technoblogy/alphanumeric-display/README.md

# Eight-Character Alphanumeric Display
An eight-character alphanumeric LED display with an I2C interface, based on four two-character 14-segment alphanumeric display modules and a low-cost HT16K33 display-driver chip.

For more information see: <http://www.technoblogy.com/show?2ULE>.
