technoblogy/alphanumeric-display/AlphanumericDisplaySchematic.gif

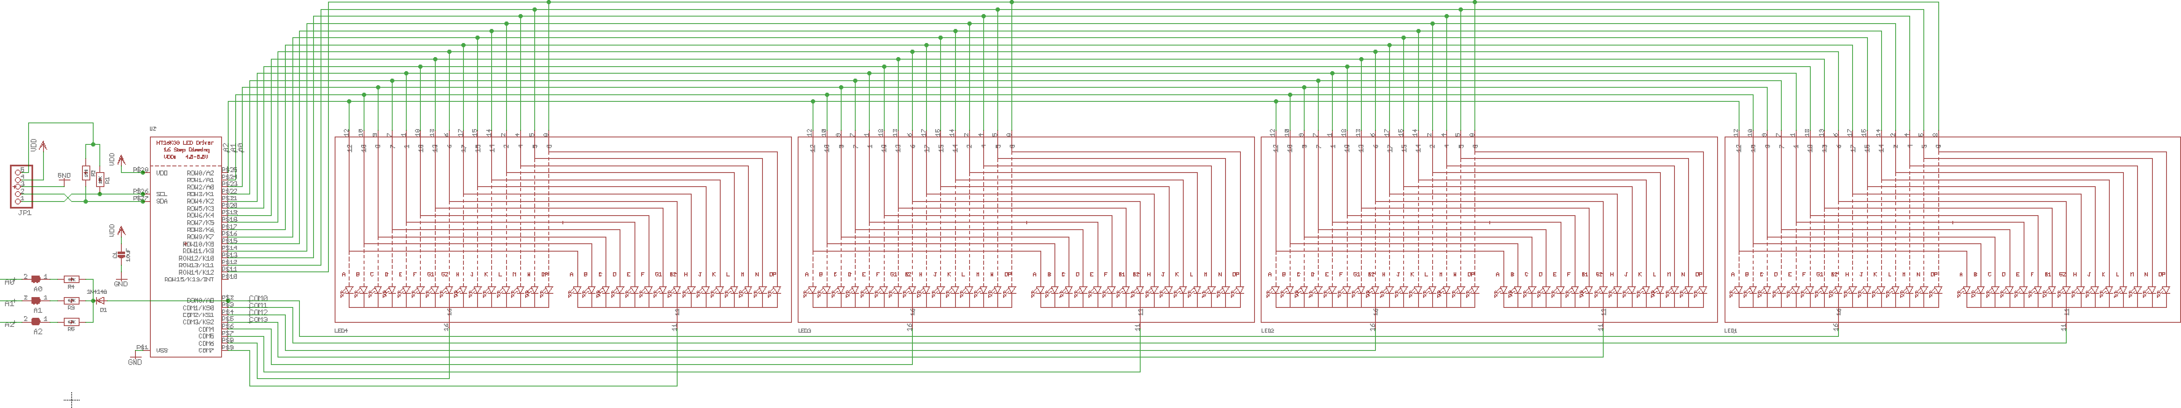
AlphanumericDisplaySchematic.gif
