technoblogy/alphanumeric-display/Eagle files/AlphanumericDisplay.brd

## EAGLE design Eagle files/AlphanumericDisplay.brd (2019-12-16)

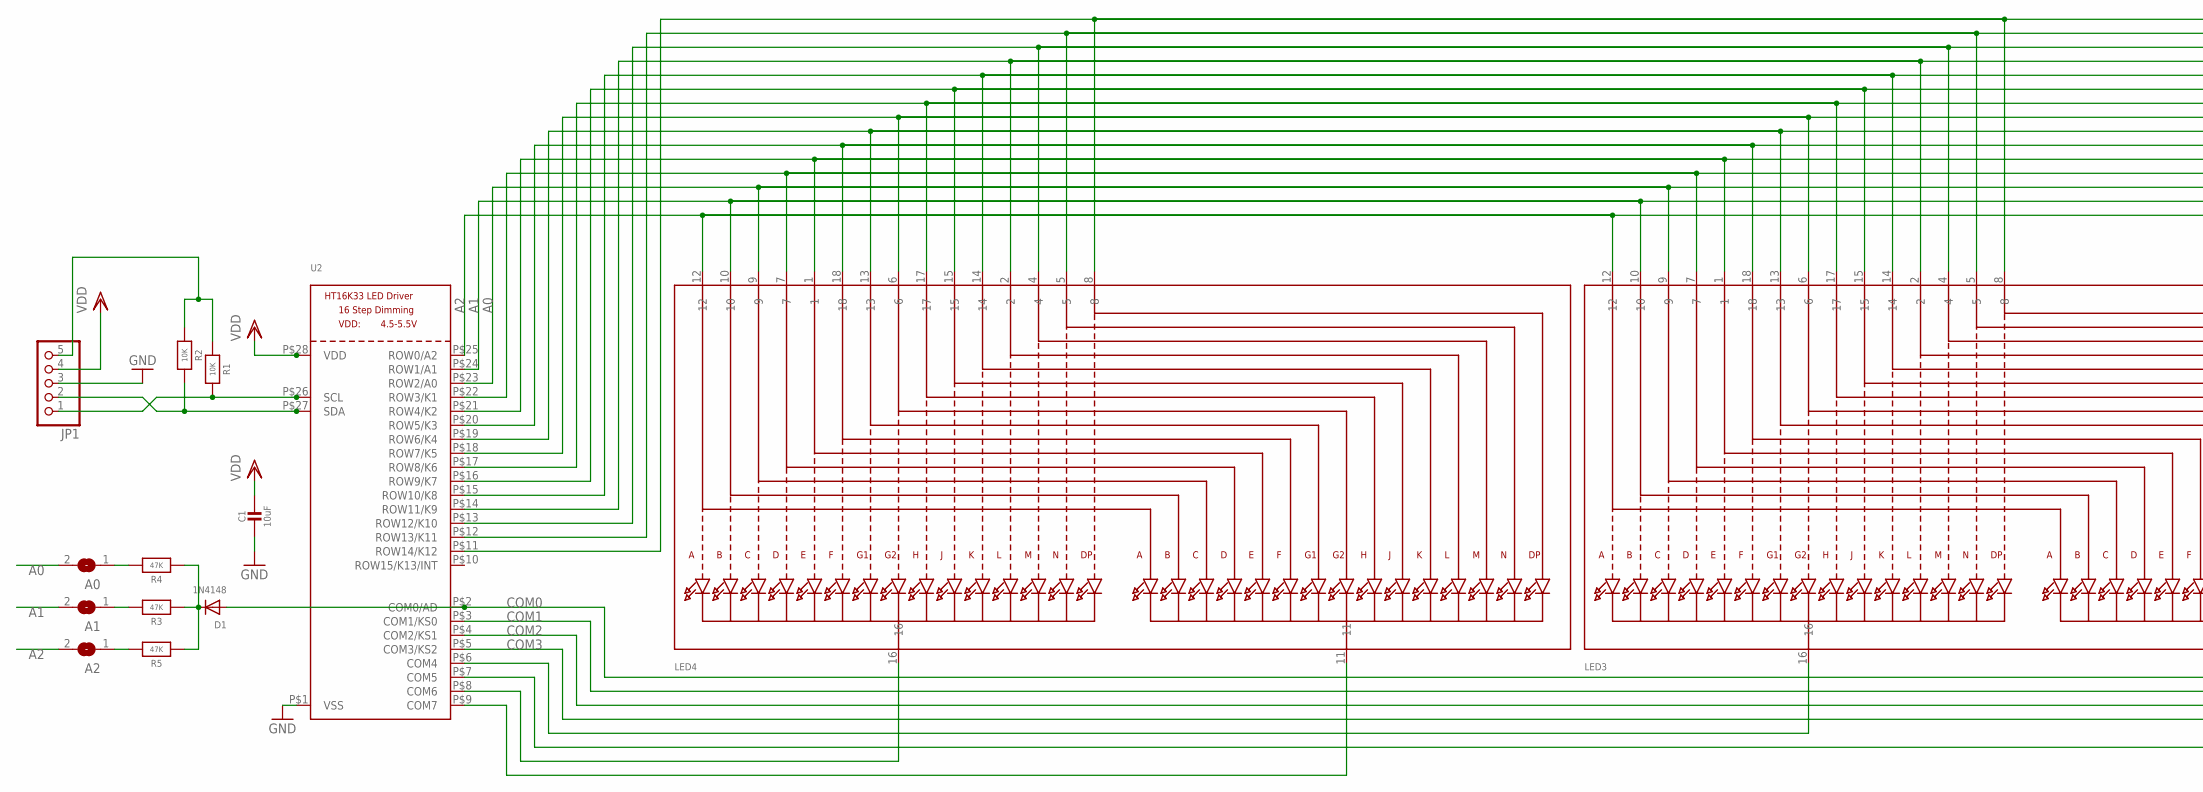
[picture p2: schematic AlphanumericDisplay.sch, part in row 1, column 1]

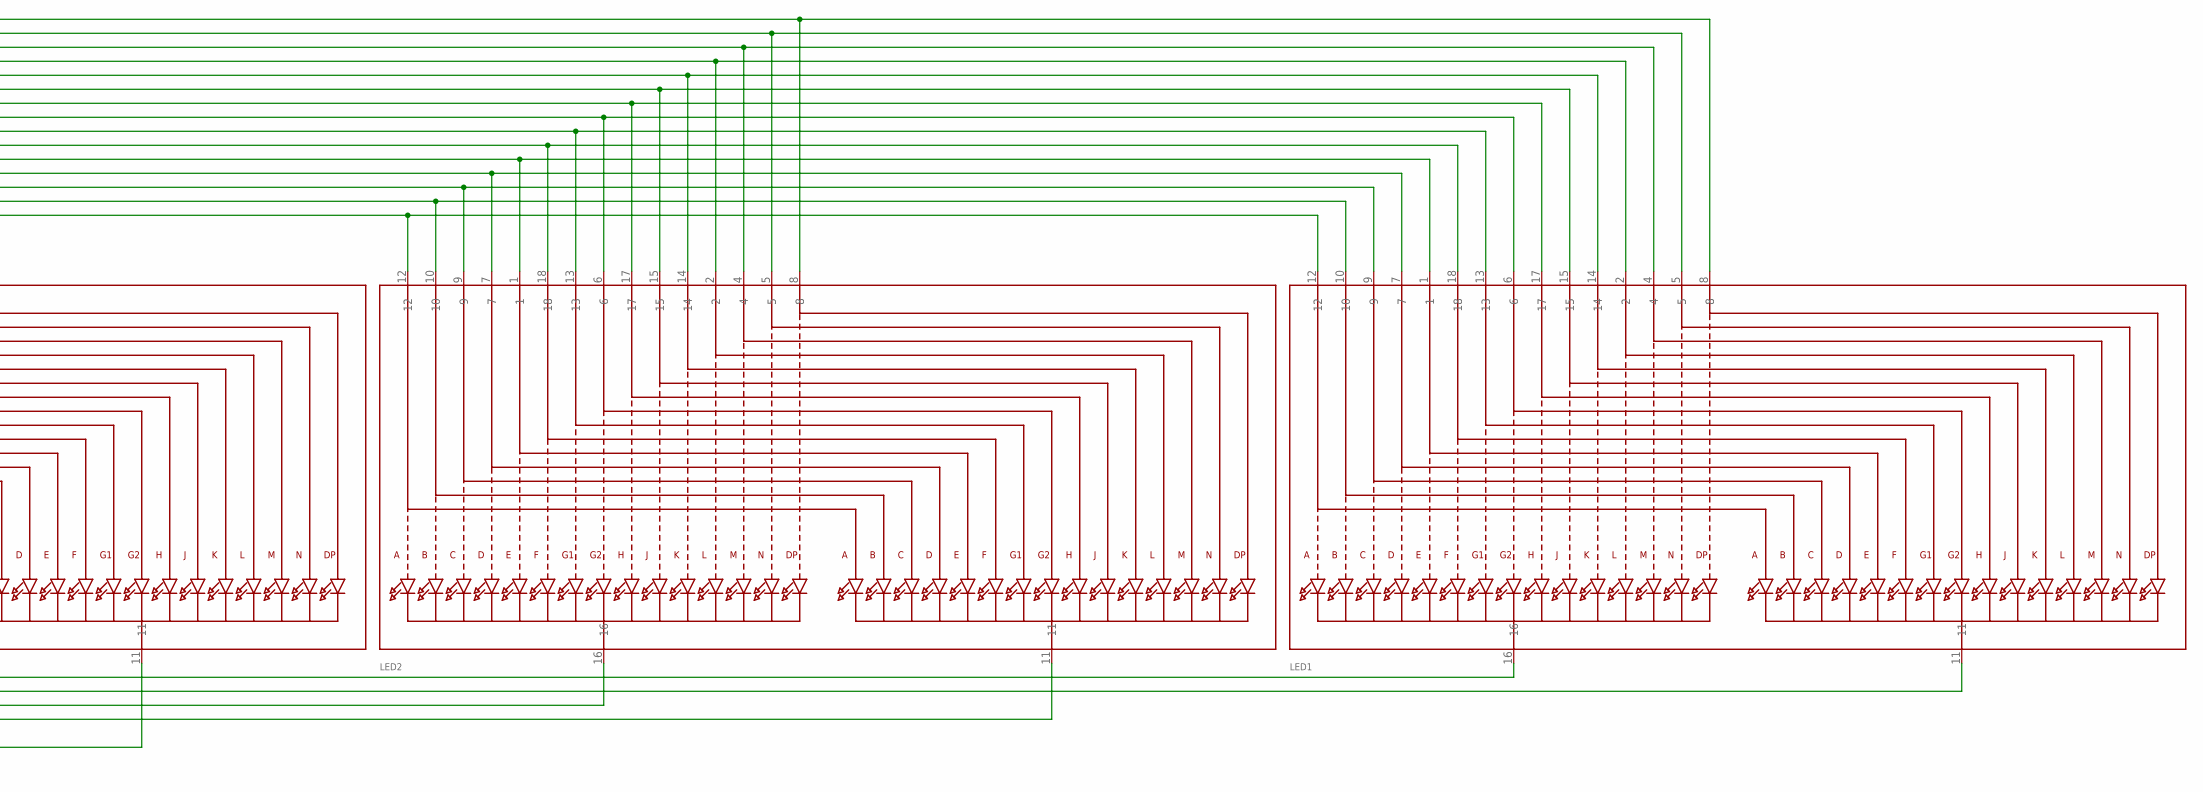
[picture p3: schematic AlphanumericDisplay.sch, part in row 1, column 2]

Parts:
A0, A1, A2: SOLDERJUMPERREFLOW_NOPASTE; SOLDERJUMPER_REFLOW_NOPASTE
C1: 10uF; 0805-NO
D1: 1N4148; SOD-323F
JP1: HEADER-1X570MIL; 1X05_ROUND_70
LED1, LED2, LED3, LED4: DISP_SEGMENT_STARBURST_DUAL_COMMONCATHODE; SEGMENT_STARTBUST_DUAL_KWA-541CBB
R1, R2: 10K; 0805-NO
R3, R4, R5: 47K; 0805-NO
U2: HT16K33_SOP28; SOP28_300MIL

Connections:
A0: A0.2, LED1.9, LED2.9, LED3.9, LED4.9, U2.P$23 (ROW2/A0)
A1: A1.2, LED1.10, LED2.10, LED3.10, LED4.10, U2.P$24 (ROW1/A1)
A2: A2.2, LED1.12, LED2.12, LED3.12, LED4.12, U2.P$25 (ROW0/A2)
COM0: D1.A, LED1.16, U2.P$2 (COM0/AD)
COM1: LED1.11, U2.P$3 (COM1/KS0)
COM2: LED2.16, U2.P$4 (COM2/KS1)
COM3: LED2.11, U2.P$5 (COM3/KS2)
COM4: LED3.16, U2.P$6 (COM4)
COM5: LED3.11, U2.P$7 (COM5)
GND: C1.2, JP1.3, U2.P$1 (VSS)
unnamed: D1.C, R3.1, R4.1, R5.1
unnamed: JP1.5, R1.1, R2.1
unnamed: LED1.17, LED2.17, LED3.17, LED4.17, U2.P$17 (ROW8/K6)
unnamed: LED1.15, LED2.15, LED3.15, LED4.15, U2.P$16 (ROW9/K7)
unnamed: LED1.14, LED2.14, LED3.14, LED4.14, U2.P$15 (ROW10/K8)
unnamed: A2.1, R5.2
unnamed: LED1.2, LED2.2, LED3.2, LED4.2, U2.P$14 (ROW11/K9)
unnamed: LED1.4, LED2.4, LED3.4, LED4.4, U2.P$13 (ROW12/K10)
unnamed: LED1.7, LED2.7, LED3.7, LED4.7, U2.P$22 (ROW3/K1)
unnamed: LED1.1, LED2.1, LED3.1, LED4.1, U2.P$21 (ROW4/K2)
unnamed: LED1.18, LED2.18, LED3.18, LED4.18, U2.P$20 (ROW5/K3)
unnamed: LED1.13, LED2.13, LED3.13, LED4.13, U2.P$19 (ROW6/K4)
unnamed: LED1.5, LED2.5, LED3.5, LED4.5, U2.P$12 (ROW13/K11)
unnamed: LED1.8, LED2.8, LED3.8, LED4.8, U2.P$11 (ROW14/K12)
unnamed: LED1.6, LED2.6, LED3.6, LED4.6, U2.P$18 (ROW7/K5)
unnamed: A1.1, R3.2
unnamed: A0.1, R4.2
unnamed: LED4.16, U2.P$8 (COM6)
unnamed: LED4.11, U2.P$9 (COM7)
SCL: JP1.1, R1.2, U2.P$26 (SCL)
SDA: JP1.2, R2.2, U2.P$27 (SDA)
VDD: C1.1, JP1.4, U2.P$28 (VDD)

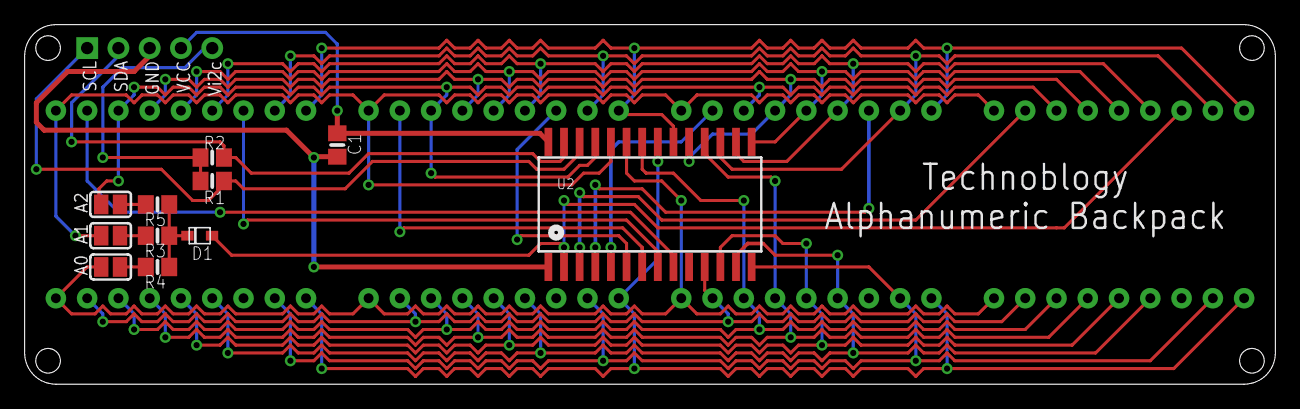
[picture p4: board AlphanumericDisplay.brd from above]

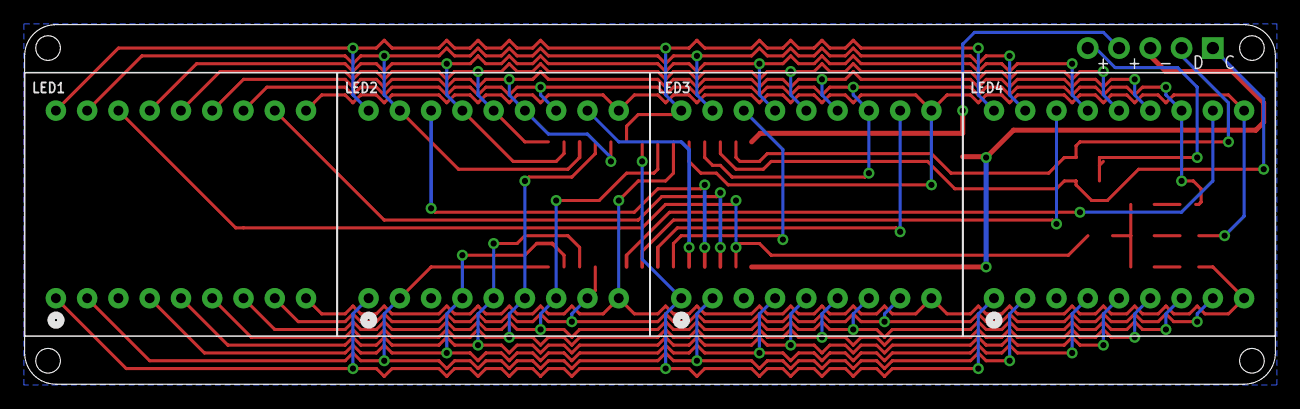
[picture p5: board AlphanumericDisplay.brd from below]

Board: 2 copper layers, 101.6 x 29.2 mm, 16 parts (4 on the bottom side), 32 nets.
