technoblogy/alphanumeric-display/(threads)

Thread 1 (2025-09-05):

HT16K33 schematic segment N and L

JackBerg, 2025-09-05:
The HT16K33 schematic

from the 14 segment Led display :
the segment N pin number should read 2 and be connected to the IC pin 14
the segment L pin number should read 5 and be connected to the IC pin 12

technoblogy, 2025-09-05:
Thanks for the issue report. What makes you think the connections were wrong? Where are you getting your information from?

JackBerg, 2025-09-05:
Hi David, 
please compare the eagle gerber file with the schematic
theses files came from your github.
Regards.

    On Friday, September 5, 2025 at 06:21:22 a.m. EDT, David Johnson-Davies ***@***.***> wrote:

 technoblogy left a comment (technoblogy/alphanumeric-display#1)
Thanks for the issue report. What makes you think the connections were wrong? Where are you getting your information from?

—
Reply to this email directly, view it on GitHub, or unsubscribe.
You are receiving this because you authored the thread.Message ID: ***@***.***>

technoblogy, 2025-09-05:
Sorry, it all looks correct to me. What are you saying is wrong? The schematic on my Technoblogy page, or the one in AlphanumericDisplay.sch. Have you built the display and found a problem?

technoblogy, 2025-09-05:
Ah! Perhaps what you are referring to is the labelling of the segments on the picture of the display? There L and N are indeed swapped; it should be:

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

technoblogy, 2025-09-05:
I've corrected it now. Thanks for reporting it.

JackBerg, 2025-09-05:
Hello David, 
please correct me if I'm wrong about the COM0,7 common digit display
from the gerber file, it use pin 12 & 17 for common digit
does the gerber file was not updated.
the parts number from your article specified 3 display with common digit pin 11 and 16 
LDS-5241BX             KWA-541AWB-Y       PDC54-11SYKWA     
Kind regards.

    On Friday, September 5, 2025 at 10:30:00 a.m. EDT, ***@***.*** ***@***.***> wrote:

  Hello David, 
my finding reside on 2 version of this display with the same part number as (5241AS)
this is very confusing since the inversion of segment N,L
the difference will affect the characters that use segment N,L

1 )  Segment        Pin #             5241AS       Technoblogy                 L                2                 N               5
aliexpress link:https://www.aliexpress.com/item/1005007617918280.html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

2 )  Segment        Pin #           5241AS             as per aliexpress module                 L                5                 N               2

aliexpress link:
https://www.aliexpress.com/item/1005009485498970.html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
I have modules from aliexpress
they use display part # 5241AS with the 
IC pin 14 to display pin 2 segment NIC pin 12 to display pin 5 segment L
aliexpress HT16K33 module
https://www.aliexpress.com/item/1005006220796489.html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

Technoblogy                                                                aliexpressdisplay    segment          IC                                    display     segment        ICPin #                               Pin #                               Pin #                              Pin #
2              L                     14                                   5                 L                 125              N                    12                                   2                 N                 14

Regards.

    On Friday, September 5, 2025 at 09:23:15 a.m. EDT, David Johnson-Davies ***@***.***> wrote:

 technoblogy left a comment (technoblogy/alphanumeric-display#1)
Sorry, it all looks correct to me. What are you saying is wrong? The schematic on my Technoblogy page, or the one in AlphanumericDisplay.sch. Have you built the display and found a problem?

—
Reply to this email directly, view it on GitHub, or unsubscribe.
You are receiving this because you authored the thread.Message ID: ***@***.***>

JackBerg, 2025-09-05:
thank you David for the follow up.

    On Friday, September 5, 2025 at 12:38:31 p.m. EDT, David Johnson-Davies ***@***.***> wrote:

 technoblogy left a comment (technoblogy/alphanumeric-display#1)
The Gerber files were generated from the Eagle files in the repository, and all the segments were correct for the displays I was using, referenced in the article. However if you have some displays with the segments swapped you can just correct for it in the driver software.

—
Reply to this email directly, view it on GitHub, or unsubscribe.
You are receiving this because you authored the thread.Message ID: ***@***.***>

JackBerg, 2025-09-06:
Hello David, 
I downloaded the eagle pcb file an ordered some PCBcan you let me know what is the 14 segment led display you usewith common pin 12 & 17 and the distributor so I can order.
thank you
    On Friday, September 5, 2025 at 12:38:31 p.m. EDT, David Johnson-Davies ***@***.***> wrote:

 technoblogy left a comment (technoblogy/alphanumeric-display#1)
The Gerber files were generated from the Eagle files in the repository, and all the segments were correct for the displays I was using, referenced in the article. However if you have some displays with the segments swapped you can just correct for it in the driver software.

—
Reply to this email directly, view it on GitHub, or unsubscribe.
You are receiving this because you authored the thread.Message ID: ***@***.***>

technoblogy, 2025-09-06:
See: http://www.technoblogy.com/show?2ULE#display-modules

JackBerg, 2025-09-06:
none of the listed display use pin 7 & 12 as per the gerber file.
so I can use any display with pin 6 & 11, solder theses on your pcb design and it will work?

    On Saturday, September 6, 2025 at 02:06:58 p.m. EDT, David Johnson-Davies ***@***.***> wrote:

 technoblogy left a comment (technoblogy/alphanumeric-display#1)
See: http://www.technoblogy.com/show?2ULE#display-modules

—
Reply to this email directly, view it on GitHub, or unsubscribe.
You are receiving this because you authored the thread.Message ID: ***@***.***>

technoblogy, 2025-09-07:
I built the displays myself using boards from PCBWay.

The displays need to be common cathode, and the common pins are 11 and 16. Those pin numbers were missing from the circuit diagram in the article (I've added them now), but they are in the schematic on GitHub, AlphanumericDisplay.sch. Perhaps you don't have a way of reading that? Here's a copy:

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

Closed 2025-09-06.
