technoblogy/alphanumeric-display/(commit log)

2019-12-16 Version 1 - 16th December 2019
    [AlphanumericDisplay.brd, AlphanumericDisplay.sch]
2020-01-07 Rename folder
    [AlphanumericDisplay.brd, AlphanumericDisplay.sch]
2021-12-11 Added Gerber files
    [AlphanumericDisplay.drills.xln]
